VDowbensky/geckokapula/hardware_v2/pcb/kapula.kicad_sch

## KiCad design hardware_v2/pcb/kapula.kicad_sch (2026-06-30)

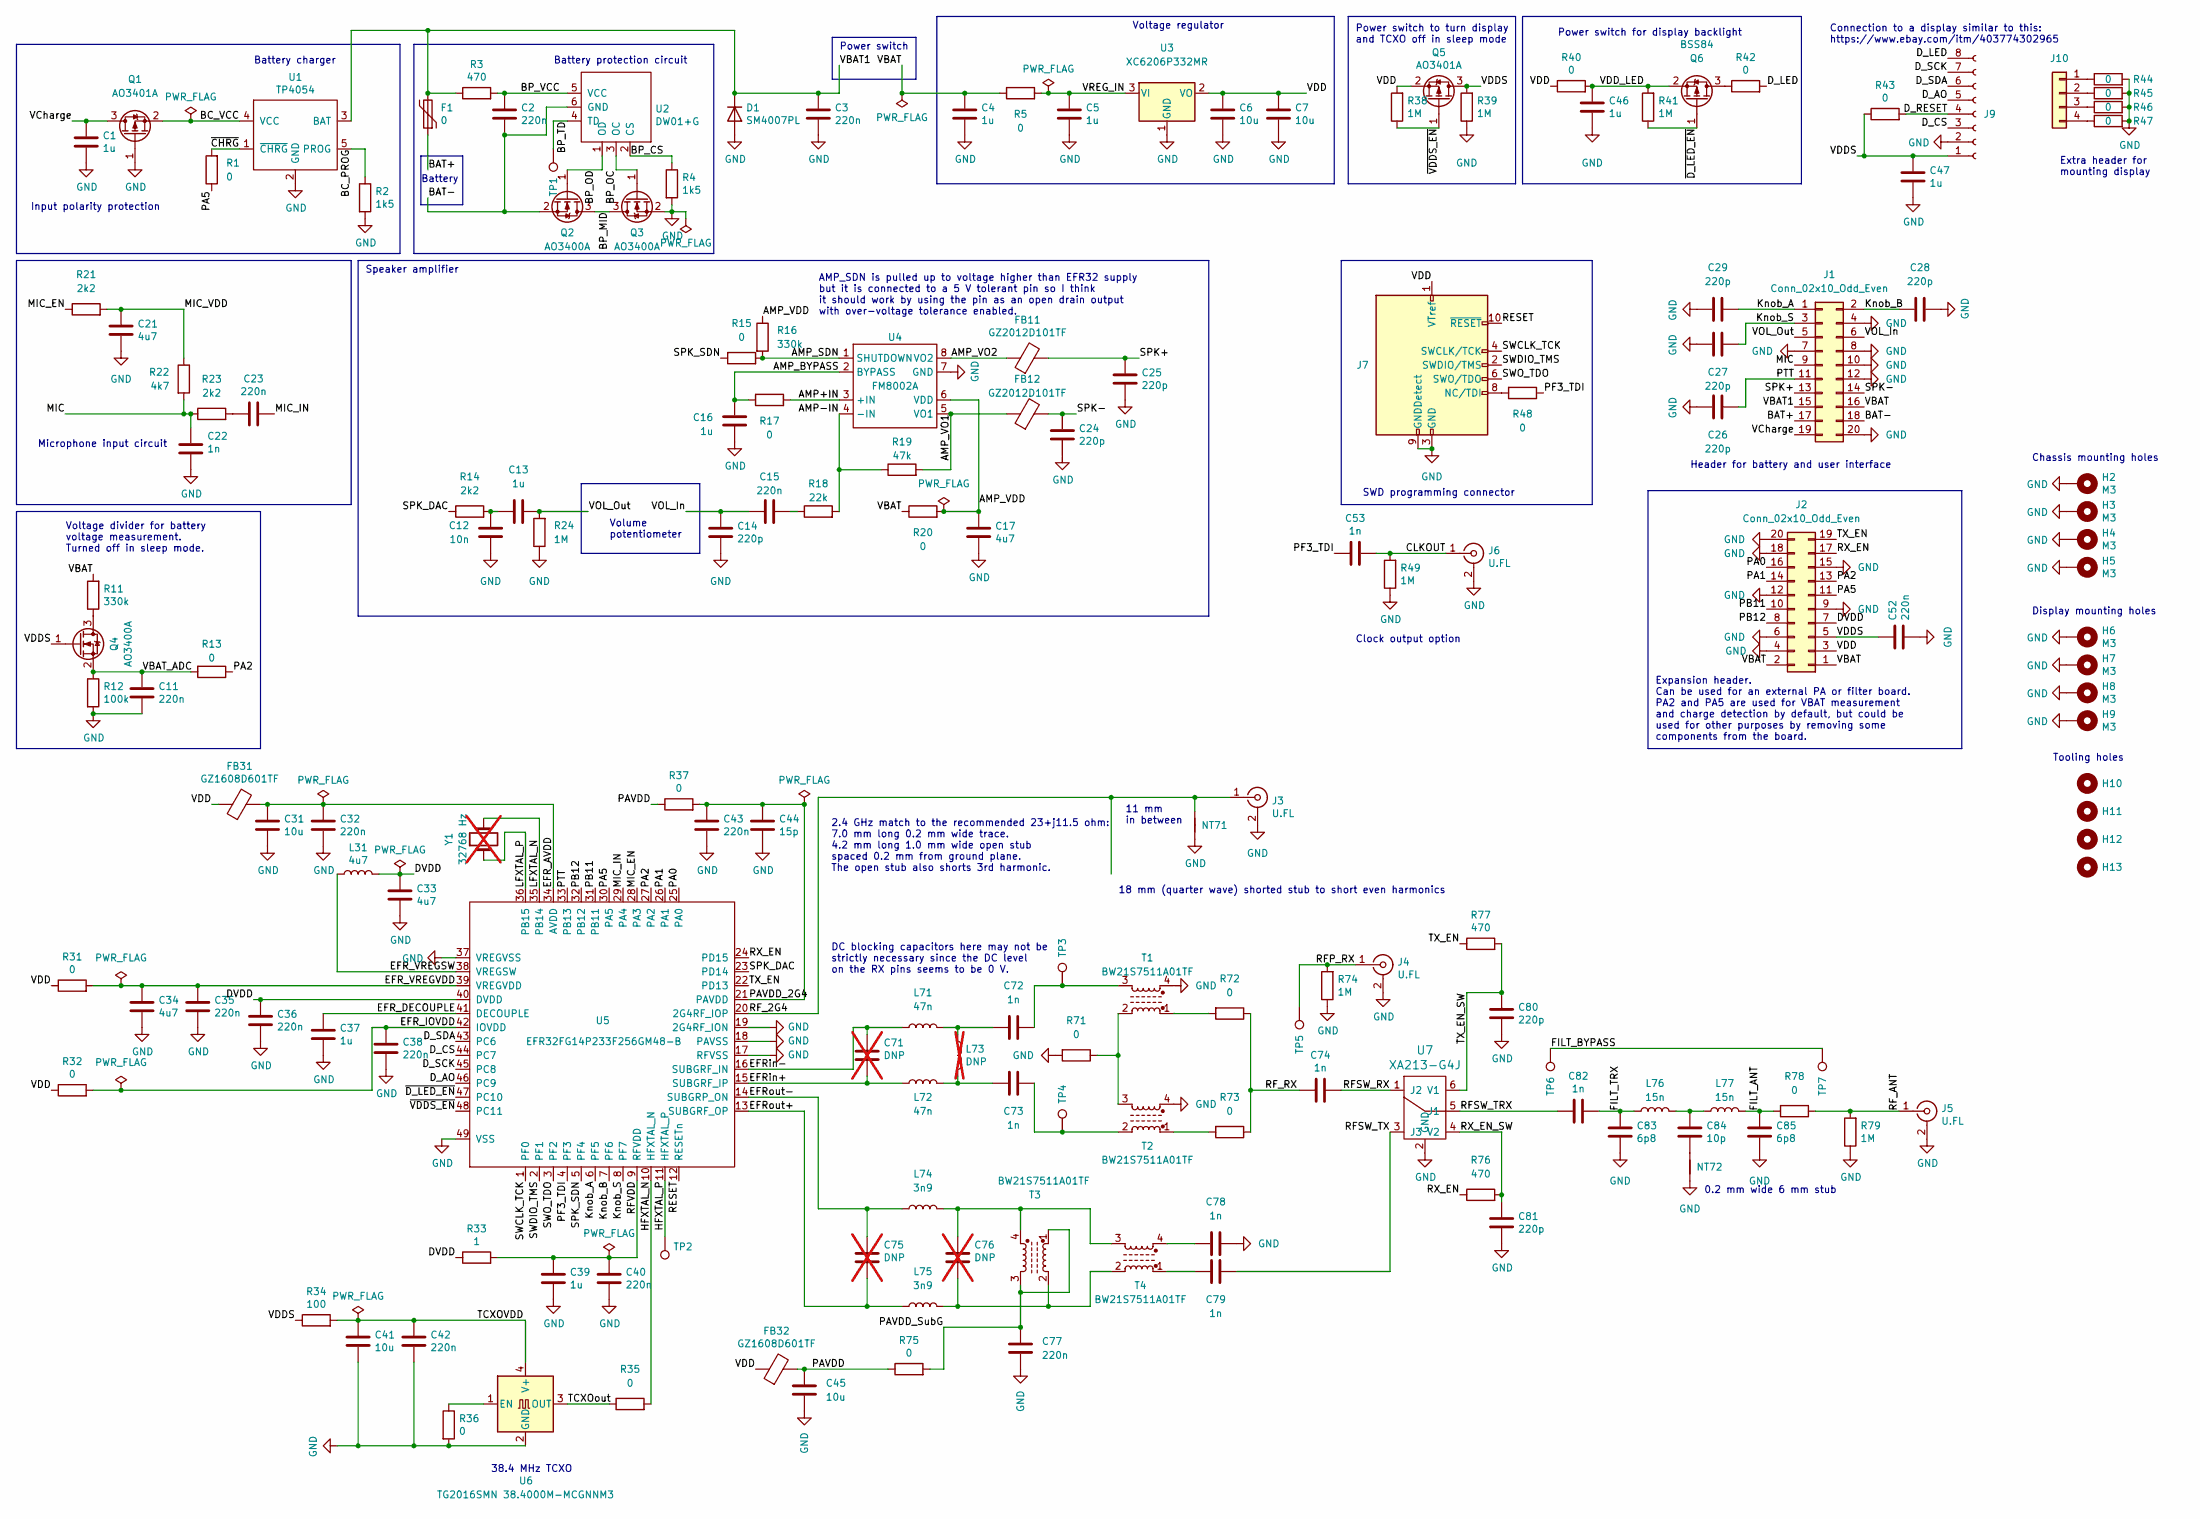
[picture p1: schematic kapula.kicad_sch]

Parts:
C1, C4, C5, C13, C16, C37, C39, C46, C47: 1u; C_0603_1608Metric; LCSC C15849
C2, C3, C11, C23, C32, C35, C36, C38, C40, C42, C43, C52, C77: 220n; C_0402_1005Metric; LCSC C16772
C6, C7, C31, C41, C45: 10u; C_0805_2012Metric; LCSC C15850
C12: 10n; C_0402_1005Metric; LCSC C15195
C14, C24, C25, C26, C27, C28, C29, C80, C81: 220p; C_0402_1005Metric; LCSC C1530
C15: 220n; C_0402_1005Metric_Pad0.74x0.62mm_HandSolder; LCSC C16772
C17, C21, C33, C34: 4u7; C_0805_2012Metric; LCSC C1779
C22, C53, C72, C73, C78, C79: 1n; C_0402_1005Metric; LCSC C1523
C44: 15p; C_0402_1005Metric; LCSC C1548
C71: DNP; C_0402_1005Metric; not fitted
C74, C82: 1n; C_0603_1608Metric_Pad1.08x0.95mm_HandSolder; LCSC C1588
C75, C76: DNP; C_0402_1005Metric_Pad0.74x0.62mm_HandSolder; not fitted
C83, C85: 6p8; C_0603_1608Metric_Pad1.08x0.95mm_HandSolder; LCSC C1679
C84: 10p; C_0603_1608Metric_Pad1.08x0.95mm_HandSolder; LCSC C1634
D1: SM4007PL; D_SOD-123F; LCSC C64898
F1: 0; R_1206_3216Metric_Pad1.30x1.75mm_HandSolder; LCSC C17888
FB11, FB12: GZ2012D101TF; L_0805_2012Metric_Pad1.05x1.20mm_HandSolder; LCSC C1015
FB31, FB32: GZ1608D601TF; L_0603_1608Metric_Pad1.05x0.95mm_HandSolder; LCSC C1002
H2, H3, H4, H5, H6, H7, H8, H9: M3; MountingHole_3.2mm_M3_Pad
H10, H11, H12, H13: ToolingHole
J1, J2: Conn_02x10_Odd_Even; PinHeader_2x10_P2.54mm_Vertical
J3, J4, J5, J6: U.FL; U.FL_Hirose_U.FL-R-SMT-1_Vertical; LCSC C88374
J7: PinHeader_2x05_P2.54mm_Vertical
J9: PinSocket_1x08_P2.54mm_Vertical
J10: PinSocket_1x04_P2.54mm_Vertical
L31: 4u7; L_1206_3216Metric; LCSC C1049
L71, L72: 47n; L_0402_1005Metric_Pad0.77x0.64mm_HandSolder; LCSC C27151
L73: DNP; L_0402_to_0603_HandSolder; not fitted
L74, L75: 3n9; L_0402_1005Metric_Pad0.77x0.64mm_HandSolder; LCSC C14033
L76, L77: 15n; L_0402_1005Metric_Pad0.77x0.64mm_HandSolder; LCSC C27143
NT71: NetTie-2_SMD_Pad0.3mm
NT72: NetTie-2_SMD_Pad0.2mm
Q1, Q5: AO3401A; SOT-23; LCSC C15127
Q2, Q3, Q4: AO3400A; SOT-23; LCSC C20917
Q6: BSS84; SOT-23; LCSC C8492
R1, R5, R13, R35, R44, R45, R46, R47, R48, R78: 0; R_0603_1608Metric_Pad0.98x0.95mm_HandSolder; LCSC C21189
R2: 1k5; R_0603_1608Metric_Pad0.98x0.95mm_HandSolder; LCSC C22843
R3, R76, R77: 470; R_0402_1005Metric; LCSC C25117
R4: 1k5; R_0603_1608Metric; LCSC C22843
R11: 330k; R_0402_1005Metric_Pad0.72x0.64mm_HandSolder; LCSC C25778
R12: 100k; R_0402_1005Metric_Pad0.72x0.64mm_HandSolder; LCSC C25741
R14, R21, R23: 2k2; R_0402_1005Metric; LCSC C25879
R15, R17, R20, R31, R32, R36, R37, R40, R42, R43, R71, R72, R73, R75: 0; R_0402_1005Metric; LCSC C17168
R16: 330k; R_0402_1005Metric; LCSC C25778
R18: 22k; R_0603_1608Metric_Pad0.98x0.95mm_HandSolder; LCSC C31850
R19: 47k; R_0603_1608Metric_Pad0.98x0.95mm_HandSolder; LCSC C25819
R22: 4k7; R_0402_1005Metric; LCSC C25900
R24, R38, R39, R41, R49, R74, R79: 1M; R_0402_1005Metric; LCSC C26083
R33: 1; R_0603_1608Metric_Pad0.98x0.95mm_HandSolder; LCSC C22936
R34: 100; R_0603_1608Metric_Pad0.98x0.95mm_HandSolder; LCSC C22775
T1, T2, T3, T4: BW21S7511A01TF; BW21S; LCSC C138776
TP1, TP2, TP5, TP6, TP7: Pad_1mm
TP3, TP4: Pad_0402_1005Metric
U1: TP4054; SOT-23-5_HandSoldering; LCSC C32574
U2: DW01+G; SOT-23-6_Handsoldering; LCSC C14213
U3: XC6206P332MR; SOT-23; LCSC C5446
U4: FM8002A; SOP-8_3.9x4.9mm_P1.27mm; LCSC C94625
U5: EFR32FG14P233F256GM48-B; QFN-48-1EP_7x7mm_P0.5mm_EP5.3x5.3mm
U6: TG2016SMN 38.4000M-MCGNNM3; TG2016SMN; LCSC C1987359
U7: XA213-G4J; SOT-363_SC-70-6; LCSC C556294
Y1: 32768 Hz; Crystal_SMD_3215-2Pin_3.2x1.5mm; not fitted

Connections:
AMP+IN: R17.2, U4.3 (+IN)
AMP-IN: R18.2, R19.1, U4.4 (-IN)
AMP_BYPASS: C16.1, R17.1, U4.2 (BYPASS)
AMP_SDN: R15.2, R16.2, U4.1 (SHUTDOWN)
AMP_VDD: C17.1, R16.1, R20.2, U4.6 (VDD)
AMP_VO1: FB12.1, R19.2, U4.5 (VO1)
AMP_VO2: FB11.1, U4.8 (VO2)
BAT+: F1.1, J1.17
BAT-: C2.2, J1.18, Q2.2 (S), U2.6 (GND)
BC_PROG: R2.1, U1.5 (PROG)
BC_VCC: Q1.2 (S), U1.4 (VCC)
BP_CS: R4.1, U2.2 (CS)
BP_MID: Q2.3 (D), Q3.3 (D)
BP_OC: Q3.1 (G), U2.3 (OC)
BP_OD: Q2.1 (G), U2.1 (OD)
BP_TD: TP1.1, U2.4 (TD)
BP_VCC: C2.1, R3.2, U2.5 (VCC)
CLKOUT: C53.2, J6.1 (In), R49.2
DVDD: C33.1, C36.1, J2.7, L31.2, R33.1, U5.40 (DVDD)
D_AO: J9.5, U5.46 (PC9)
D_CS: J9.3, U5.44 (PC7)
D_LED: J9.8, R42.2
D_RESET: J9.4, R43.2
D_SCK: J9.7, U5.45 (PC8)
D_SDA: J9.6, U5.43 (PC6)
EFR_AVDD: C31.1, C32.1, FB31.2, U5.34 (AVDD)
EFR_DECOUPLE: C37.1, U5.41 (DECOUPLE)
EFR_IOVDD: C38.1, R32.2, U5.42 (IOVDD)
EFR_VREGSW: L31.1, U5.38 (VREGSW)
EFR_VREGVDD: C34.1, C35.1, R31.2, U5.39 (VREGVDD)
EFRin+: C71.2, L72.1, U5.15 (SUBGRF_IP)
EFRin-: C71.1, L71.1, U5.16 (SUBGRF_IN)
EFRout+: C75.2, L75.2, U5.13 (SUBGRF_OP)
EFRout-: C75.1, L74.2, U5.14 (SUBGRP_ON)
FILT_ANT: C85.1, L77.2, R78.2
FILT_BYPASS: TP6.1, TP7.1
FILT_TRX: C82.1, C83.1, L76.1
GND: C1.2, C3.2, C4.2, C5.2, C6.2, C7.2, C11.2, C12.2, C14.2, C16.2, C17.2, C21.2, C22.2, C24.2, C25.2, C26.2, C27.2, C28.2, C29.2, C31.2, C32.2, C33.2, C34.2, C35.2, C36.2, C37.2, C38.2, C39.2, C40.2, C41.2, C42.2, C43.2, C44.2, C45.2, C46.2, C47.2, C52.2, C77.2, C78.1, C80.2, C81.2, C83.2, C85.2, D1.2 (A), H2.1, H3.1, H4.1, H5.1, H6.1, H7.1, H8.1, H9.1, J1.4, J1.7, J1.8, J1.10, J1.12, J1.20, J2.4, J2.6, J2.9, J2.12, J2.15, J2.18, J2.20, J3.2 (Ext), J4.2 (Ext), J5.2 (Ext), J6.2 (Ext), J7.3 (GND), J7.5 (GND), J7.9 (GNDDetect), J9.2, NT71.2, NT72.2, Q1.1 (G), Q3.2 (S), R2.2, R4.2, R12.2, R24.1, R36.2, R39.1, R44.2, R45.2, R46.2, R47.2, R49.1, R71.2, R74.1, R79.1, T1.4, T2.4, U1.2 (GND), U3.1 (GND), U4.7 (GND), U5.17 (RFVSS), U5.18 (PAVSS), U5.19 (2G4RF_ION), U5.37 (VREGVSS), U5.49 (VSS), U6.2 (GND), U7.2 (GND)
HFXTAL_N: R35.2, U5.10 (HFXTAL_N)
HFXTAL_P: TP2.1, U5.11 (HFXTAL_P)
Knob_A: C29.1, J1.1, U5.6 (PF5)
Knob_B: C28.1, J1.2, U5.7 (PF6)
Knob_S: C27.1, J1.3, U5.8 (PF7)
LFXTAL_N: U5.35 (PB14), Y1.2
LFXTAL_P: U5.36 (PB15), Y1.1
MIC: C22.1, J1.9, R22.2, R23.1
MIC_EN: R21.1, U5.28 (PA3)
MIC_IN: C23.1, U5.29 (PA4)
MIC_VDD: C21.1, R21.2, R22.1
unnamed: C12.1, C13.1, R14.2
unnamed: C15.2, R18.1
unnamed: C23.2, R23.2
unnamed: C72.1, T1.3, TP3.1
unnamed: C72.2, L71.2, L73.1
unnamed: C73.1, T2.2, TP4.1
unnamed: C73.2, L72.2, L73.2
unnamed: C76.1, L74.1, T3.4, T4.3
unnamed: C76.2, L75.1, T3.2, T4.2
unnamed: C78.2, T4.4
unnamed: C79.2, T4.1
unnamed: C84.1, L76.2, L77.1
unnamed: C84.2, NT72.1
unnamed: J7.8 (NC/TDI), R48.2
unnamed: J10.1, R44.1
unnamed: J10.2, R45.1
unnamed: J10.3, R46.1
unnamed: J10.4, R47.1
unnamed: Q4.3 (D), R11.1
unnamed: Q6.3 (D), R42.1
unnamed: R36.1, U6.1 (EN)
unnamed: R71.1, T1.2, T2.3
unnamed: R72.2, T1.1
unnamed: R73.2, T2.1
PA0: J2.16, U5.25 (PA0)
PA1: J2.14, U5.26 (PA1)
PA2: J2.13, R13.1, U5.27 (PA2)
PA5: J2.11, R1.1, U5.30 (PA5)
PAVDD: C45.1, FB32.2, R37.1, R75.1
PAVDD_2G4: C43.1, C44.1, R37.2, U5.21 (PAVDD)
PAVDD_SubG: C77.1, R75.2, T3.1, T3.3
PB11: J2.10, U5.31 (PB11)
PB12: J2.8, U5.32 (PB12)
PF3_TDI: C53.1, R48.1, U5.4 (PF3)
PTT: C26.1, J1.11, U5.33 (PB13)
RESET: J7.10 (~RESET), U5.12 (RESETn)
RFP_RX: J4.1 (In), R74.2, TP5.1
RFSW_RX: C74.1, U7.1 (J2)
RFSW_TRX: C82.2, U7.5 (J1)
RFSW_TX: C79.1, U7.3 (J3)
RFVDD: C39.1, C40.1, R33.2, U5.9 (RFVDD)
RF_2G4: J3.1 (In), NT71.1, U5.20 (2G4RF_IOP)
RF_ANT: J5.1 (In), R78.1, R79.2
RF_RX: C74.2, R72.1, R73.1
RX_EN: J2.17, R76.1, U5.24 (PD15)
RX_EN_SW: C81.1, R76.2, U7.4 (V2)
SPK+: C25.1, FB11.2, J1.13
SPK-: C24.1, FB12.2, J1.14
SPK_DAC: R14.1, U5.23 (PD14)
SPK_SDN: R15.1, U5.5 (PF4)
SWCLK_TCK: J7.4 (SWCLK/TCK), U5.1 (PF0)
SWDIO_TMS: J7.2 (SWDIO/TMS), U5.2 (PF1)
SWO_TDO: J7.6 (SWO/TDO), U5.3 (PF2)
TCXOVDD: C41.1, C42.1, R34.2, U6.4 (V+)
TCXOout: R35.1, U6.3 (OUT)
TX_EN: J2.19, R77.1, U5.22 (PD13)
TX_EN_SW: C80.1, R77.2, U7.6 (V1)
VBAT: C4.1, J1.16, J2.1, J2.2, R5.1, R11.2, R20.1
VBAT1: C3.1, D1.1 (K), F1.2, J1.15, R3.1, U1.3 (BAT)
VBAT_ADC: C11.1, Q4.2 (S), R12.1, R13.2
VCharge: C1.1, J1.19, Q1.3 (D)
VDD: C6.1, C7.1, FB31.1, FB32.1, J2.3, J7.1 (VTref), Q5.2 (S), R31.1, R32.1, R38.2, R40.1, U3.2 (VO)
VDDS: C47.1, C52.1, J2.5, J9.1, Q4.1 (G), Q5.3 (D), R34.1, R39.2, R43.1
VDD_LED: C46.1, Q6.2 (S), R40.2, R41.2
VOL_In: C14.1, C15.1, J1.6
VOL_Out: C13.2, J1.5, R24.2
VREG_IN: C5.1, R5.2, U3.3 (VI)
~CHRG: R1.2, U1.1 (~CHRG)
~D_LED_EN: Q6.1 (G), R41.1, U5.47 (PC10)
~VDDS_EN: Q5.1 (G), R38.1, U5.48 (PC11)

Notes on the sheet:
Voltage regulator
SWD programming connector
Battery protection circuit
Header for battery and user interface
Input polarity protection
11 mm in between
Tooling holes
AMP_SDN is pulled up to voltage higher than EFR32 supply but it is connected to a 5 V tolerant pin so I think it should work by using the pin as an open drain output with over-voltage tolerance enabled.
DC blocking capacitors here may not be strictly necessary since the DC level on the RX pins seems to be 0 V.
38.4 MHz TCXO
Battery charger
Battery
Display mounting holes
Volume potentiometer
Speaker amplifier
0.2 mm wide 6 mm stub
Power switch
Connection to a display similar to this: https://www.ebay.com/itm/403774302965
Clock output option
Microphone input circuit
Chassis mounting holes
2.4 GHz match to the recommended 23+j11.5 ohm: 7.0 mm long 0.2 mm wide trace. 4.2 mm long 1.0 mm wide open stub spaced 0.2 mm from ground plane. The open stub also shorts 3rd harmonic.
Voltage divider for battery voltage measurement. Turned off in sleep mode.
Extra header for mounting display
18 mm (quarter wave) shorted stub to short even harmonics
Power switch to turn display and TCXO off in sleep mode
Power switch for display backlight
Expansion header. Can be used for an external PA or filter board. PA2 and PA5 are used for VBAT measurement and charge detection by default, but could be used for other purposes by removing some components from the board.
