VDowbensky/geckokapula/(commit log)

2024-04-09 Make SSB TX spectrum cleaner
    * Add filtering to frequency modulation
    * Reduce maximum frequency deviation
    * Reduce "loop gain"
2024-04-09 Adjust TX audio filtering
